Arthur-Demetrio/garra/servo_imgs/servo1_0.jpeg

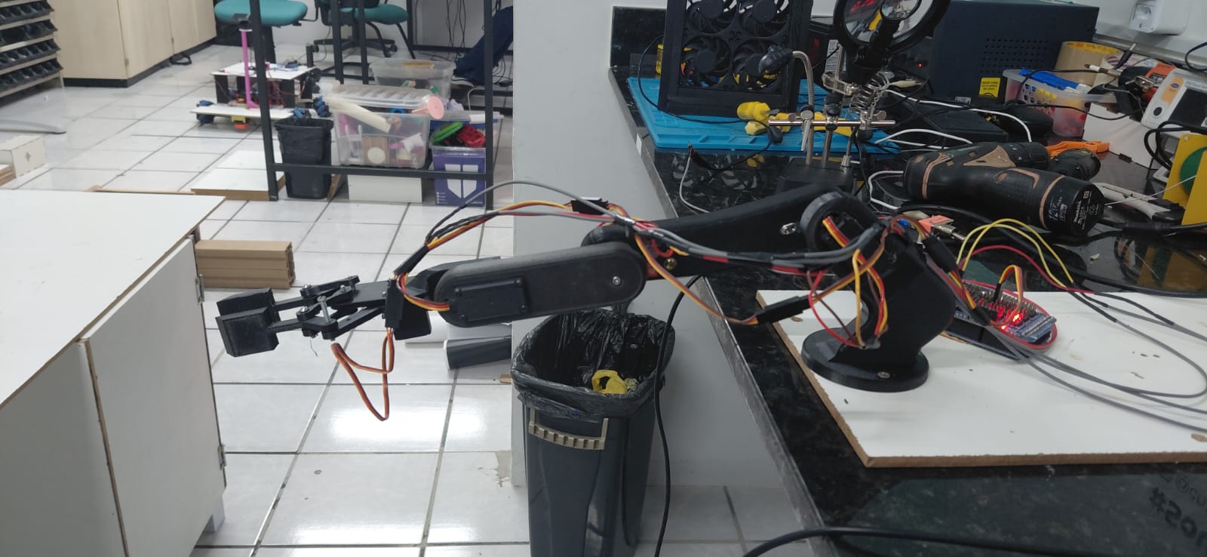
servo_imgs/servo1_0.jpeg
