Arthur-Demetrio/garra/servo_imgs/servo1_0_novo.jpeg

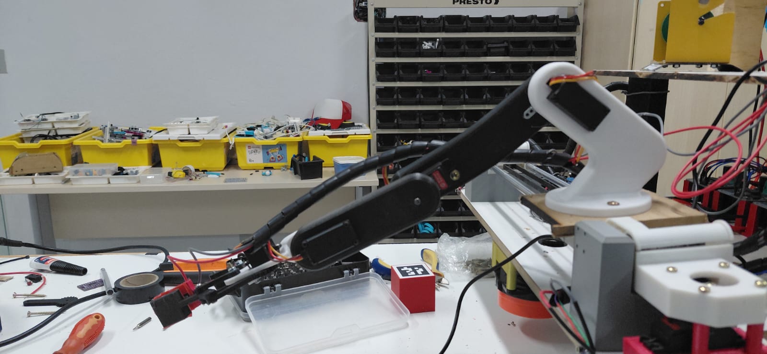
servo_imgs/servo1_0_novo.jpeg
