Arthur-Demetrio/garra/servo_imgs/servo1_180.jpeg

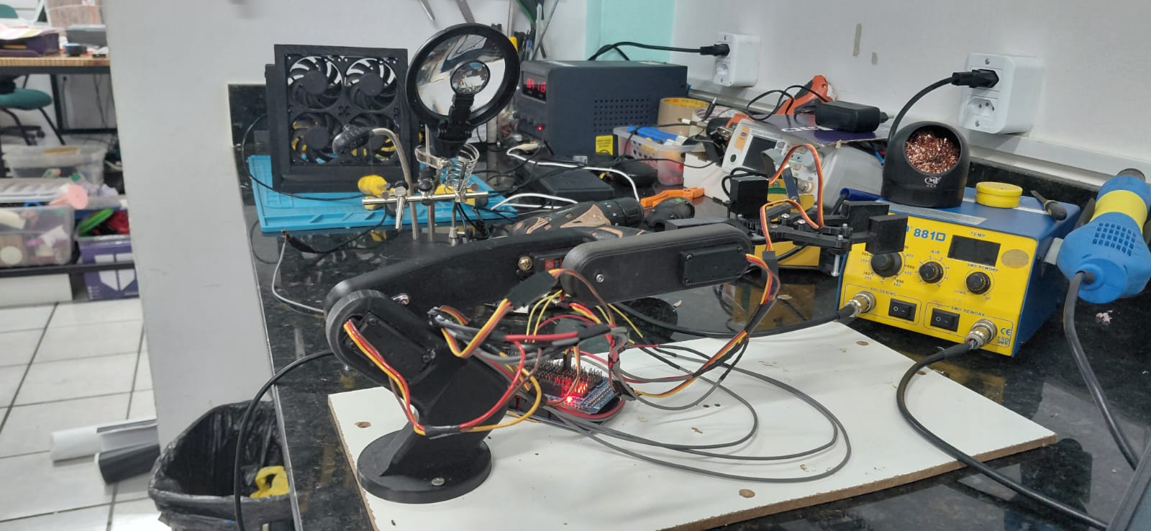
servo_imgs/servo1_180.jpeg
