Arthur-Demetrio/garra/servo_imgs/servo2_0.jpeg

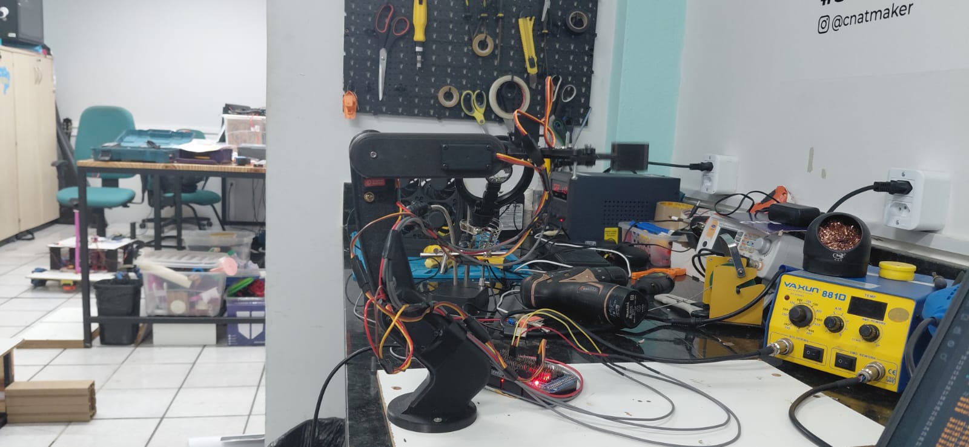
servo_imgs/servo2_0.jpeg
