Arthur-Demetrio/garra/servo_imgs/servo2_180.jpeg

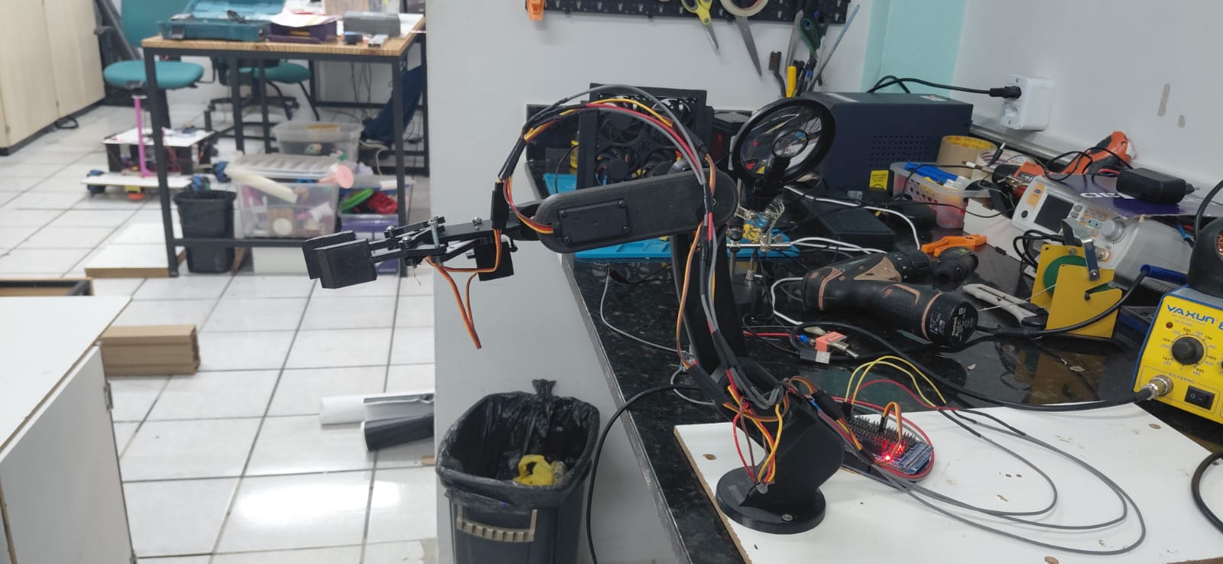
servo_imgs/servo2_180.jpeg
