Arthur-Demetrio/garra/servo_imgs/servo3_0.jpeg

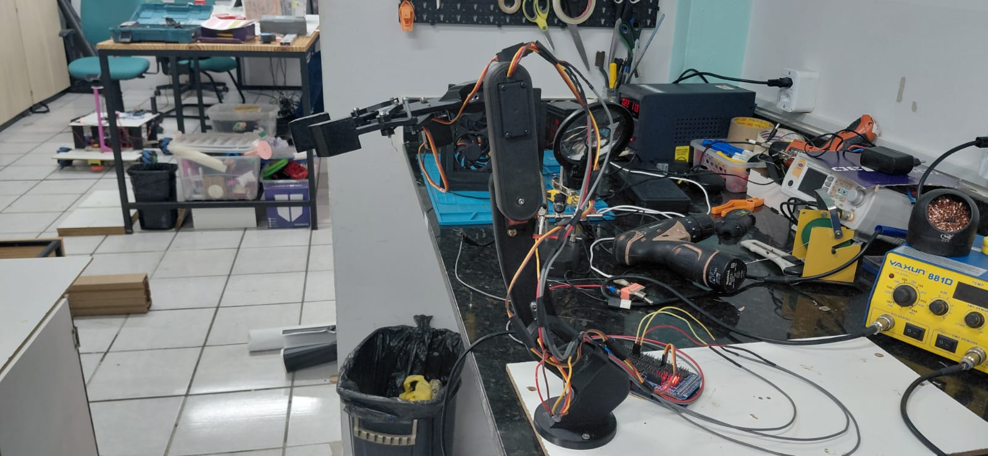
servo_imgs/servo3_0.jpeg
