Arthur-Demetrio/garra/servo_imgs/servo3_180.jpeg

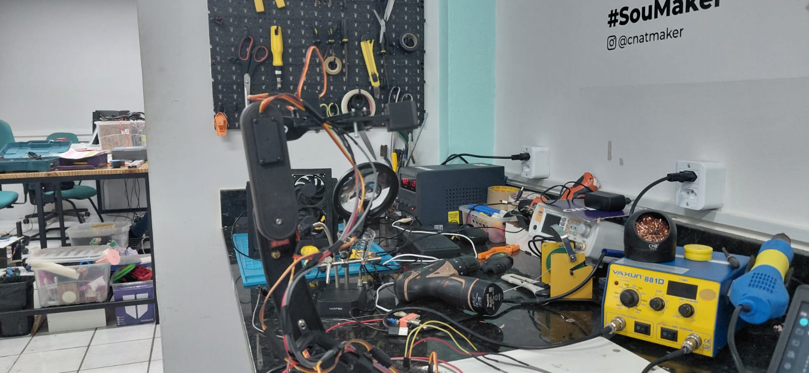
servo_imgs/servo3_180.jpeg
