Arthur-Demetrio/garra/garra_final_description/config/frame_overrides.csv

link | parent_joint | joint_type | rule | original_roll_deg | original_pitch_deg | original_yaw_deg | post_roll_deg | post_pitch_deg | post_yaw_deg | role
Base | R_gido_73 | fixed | keep | -92.083819 | 0.000000 | 90.000000 | -92.083819 | 0.000000 | 90.000000 | unchanged
Engr_1 | Revolucionar_91 | continuous | auto | -92.940419 | 44.859715 | 87.924992 | 0.000000 | 87.916181 | 0.000000 | revolute_axis_z
Engr_2 | Revolucionar_85 | continuous | auto | -92.096137 | 6.213100 | 89.773042 | 0.000000 | 87.916181 | 0.000000 | revolute_axis_z
Junta | Revolucionar_95 | continuous | auto | 87.695417 | -25.277392 | 90.984493 | 0.000000 | 87.916181 | 0.000000 | revolute_axis_z
Junta_1 | Revolucionar_87 | continuous | auto | -85.468634 | 62.597157 | -85.975312 | 0.000000 | 87.916181 | 0.000000 | revolute_axis_z
Junta_1_1 | Revolucionar_89 | continuous | auto | -87.888272 | -9.323392 | -90.342265 | 0.000000 | 87.916181 | 0.000000 | revolute_axis_z
Junta_2 | Revolucionar_93 | continuous | auto | 87.695417 | -25.277392 | 90.984493 | 0.000000 | 87.916181 | 0.000000 | revolute_axis_z
MOTOR_1 | R_gido_48 | fixed | keep | 0.000000 | -39.520181 | 0.000000 | 0.000000 | -39.520181 | 0.000000 | unchanged
MOTOR_1_1 | R_gido_65 | fixed | keep | -180.000000 | -88.536240 | 180.000000 | -180.000000 | -88.536240 | 180.000000 | unchanged
M_dulo_1 | R_gido_47 | fixed | keep | 0.000000 | -39.520181 | 0.000000 | 0.000000 | -39.520181 | 0.000000 | unchanged
M_dulo_2 | R_gido_50 | fixed | keep | -180.000000 | -88.536240 | 180.000000 | -180.000000 | -88.536240 | 180.000000 | unchanged
Motor | R_gido_77 | fixed | keep | -92.083819 | 0.000000 | 90.000000 | -92.083819 | 0.000000 | 90.000000 | unchanged
P_1 | Revolucionar_86 | continuous | auto | -92.085430 | 2.251740 | 89.918027 | 0.000000 | 87.916181 | 0.000000 | revolute_axis_z
P_1_1 | Revolucionar_92 | continuous | auto | -92.223140 | -20.387173 | 90.774800 | 0.000000 | 87.916181 | 0.000000 | revolute_axis_z
base_link |  | root | auto | 0.000000 | 0.000000 | 0.000000 | 0.000000 | 0.000000 | 0.000000 | root_x_forward_z_up
garra_final_showder_servo_horn | Revolucionar_46 | continuous | keep | 90.000000 | 65.479819 | 0.000000 | 90.000000 | 65.479819 | 0.000000 | revolute_axis_z
garra_final_showder_servo_horn_2 | Revolucionar_49 | continuous | keep | 90.000000 | 48.536240 | 0.000000 | 90.000000 | 48.536240 | 0.000000 | revolute_axis_z
garra_final_showder_servo_horn_3 | Revolucionar_72 | continuous | auto | 90.000000 | 50.416181 | 0.000000 | -90.000000 | 0.000000 | 0.000000 | revolute_axis_z
shoulder_motor | R_gido | fixed | keep | 0.000000 | 0.663392 | 0.000000 | 0.000000 | 0.663392 | 0.000000 | unchanged
