Arthur-Demetrio/garra/garra_final_description/meshes/Configura_o_1/Engr_1_collision.stl

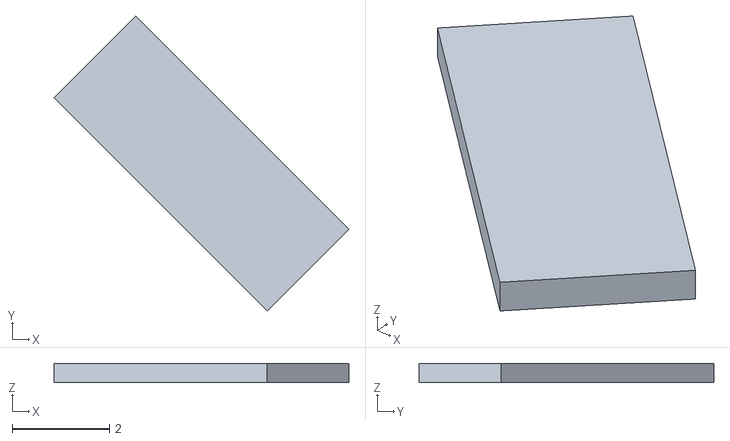
[picture p9: CAD file, 2026-11-09]
garra_final_description/meshes/Configura_o_1/Engr_1_collision.stl
6.06 x 6.06 x 0.4
