Arthur-Demetrio/garra/garra_final_description/meshes/garra_final/M_dulo_2_collision.stl

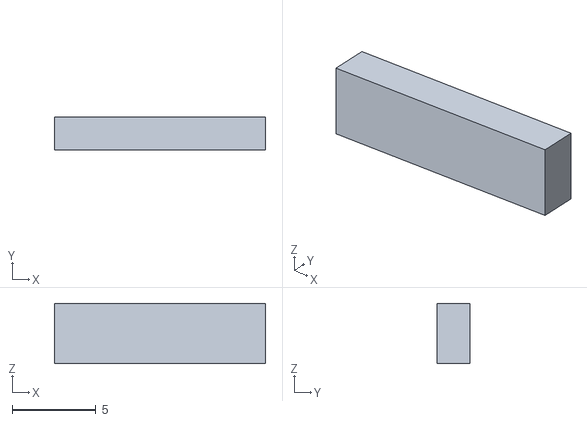
[picture p10: CAD file, 2026-11-09]
garra_final_description/meshes/garra_final/M_dulo_2_collision.stl
12.6 x 2.00 x 3.60
