Arthur-Demetrio/garra/garra_final_description/meshes/Nova_Pin_a/Componente5_collision.stl

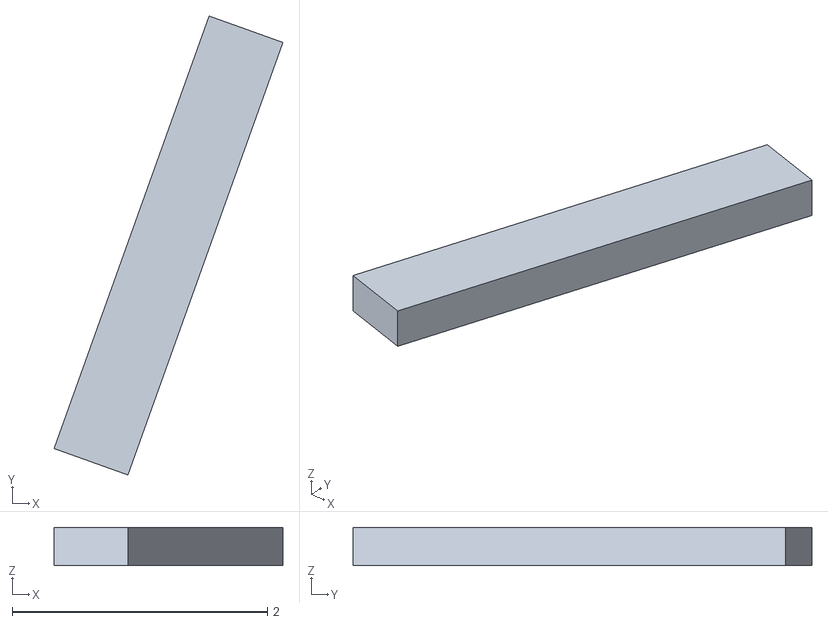
[picture p11: CAD file, 2026-10-30]
garra_final_description/meshes/Nova_Pin_a/Componente5_collision.stl
1.79 x 3.60 x 0.3
