Arthur-Demetrio/garra/garra_final_description/meshes/Configura_o_1/Junta_1_1_collision.stl

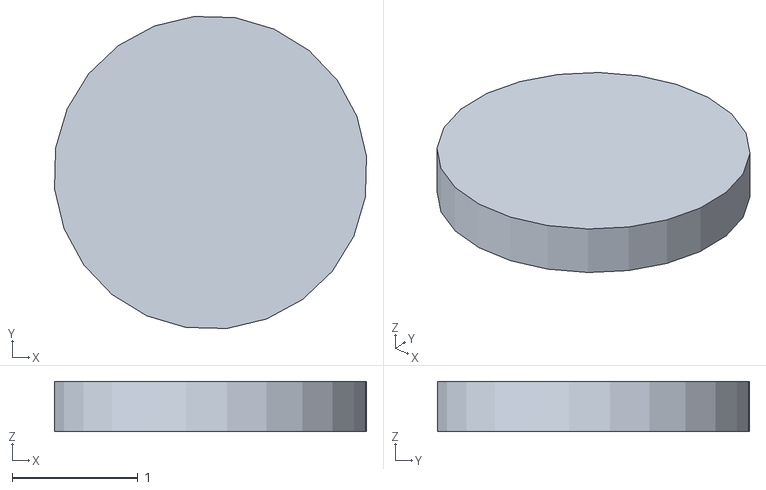
[picture p12: CAD file, 2026-11-09]
garra_final_description/meshes/Configura_o_1/Junta_1_1_collision.stl
2.48 x 2.48 x 0.4
