Arthur-Demetrio/garra/garra_final_description/meshes/garra_final/MOTOR_1_1_collision.stl

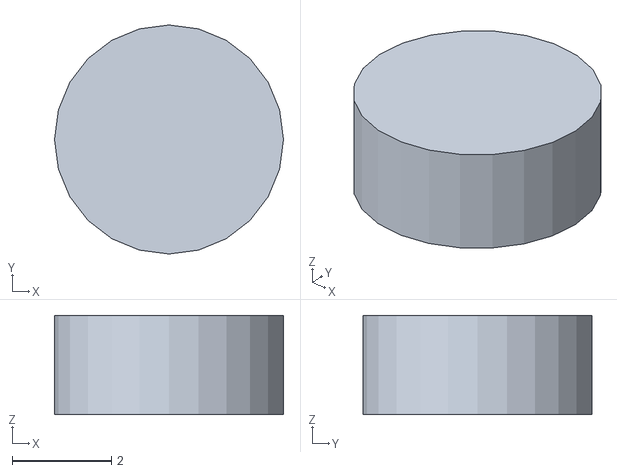
[picture p13: CAD file, 2026-11-09]
garra_final_description/meshes/garra_final/MOTOR_1_1_collision.stl
4.61 x 4.61 x 2.00
