Arthur-Demetrio/garra/garra_final_description/meshes/Nova_Pin_a/Componente6_Espelhar_collision.stl

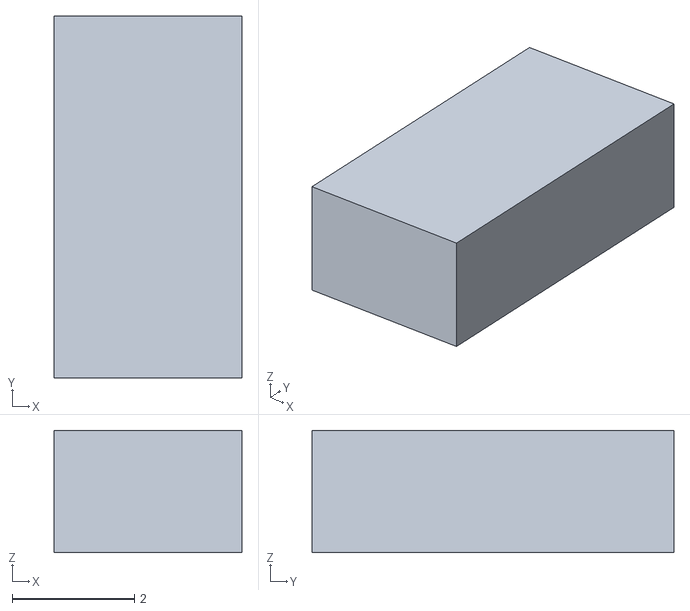
[picture p14: CAD file, 2026-10-30]
garra_final_description/meshes/Nova_Pin_a/Componente6_Espelhar_collision.stl
3.07 x 5.92 x 2.00
