Arthur-Demetrio/garra/garra_final_description/meshes/Configura_o_1/Engr_2_collision.stl

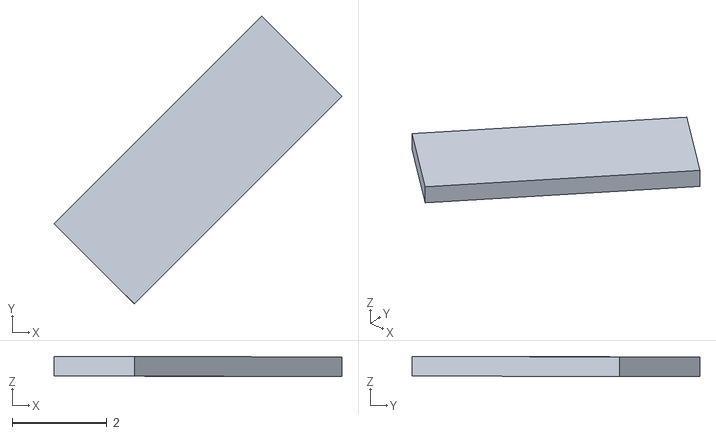
[picture p15: CAD file, 2026-11-09]
garra_final_description/meshes/Configura_o_1/Engr_2_collision.stl
6.08 x 6.08 x 0.428
