Arthur-Demetrio/garra/garra_final_description/meshes/garra_final/Caixa_motor_pequeno_collision.stl

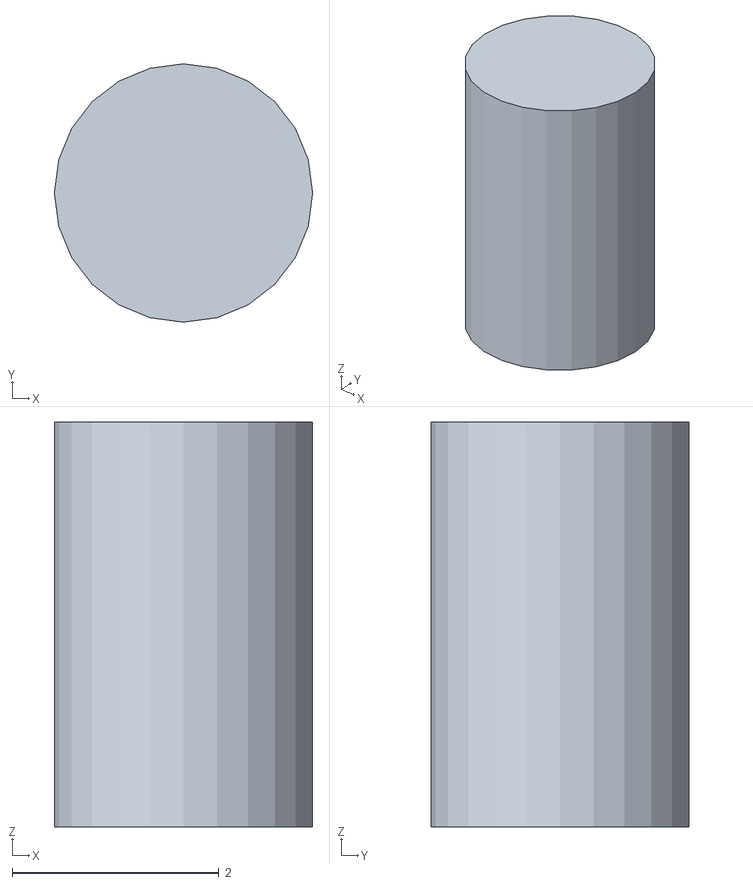
[picture p16: CAD file, 2026-10-30]
garra_final_description/meshes/garra_final/Caixa_motor_pequeno_collision.stl
2.50 x 2.50 x 3.92
