Arthur-Demetrio/garra/garra_final_description/meshes/Nova_Pin_a/Componente4_collision.stl

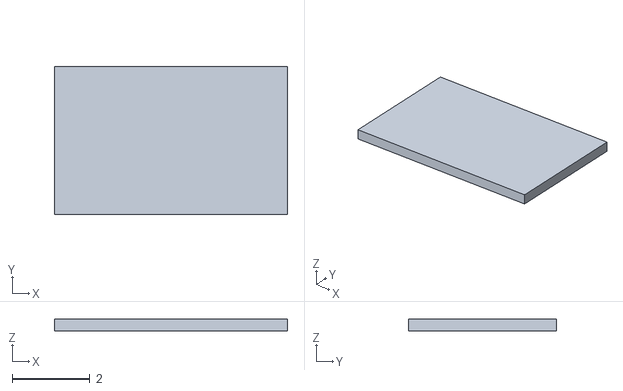
[picture p17: CAD file, 2026-10-30]
garra_final_description/meshes/Nova_Pin_a/Componente4_collision.stl
6.00 x 3.80 x 0.3
