Arthur-Demetrio/garra/garra_final_description/meshes/garra_final/base_link_collision.stl

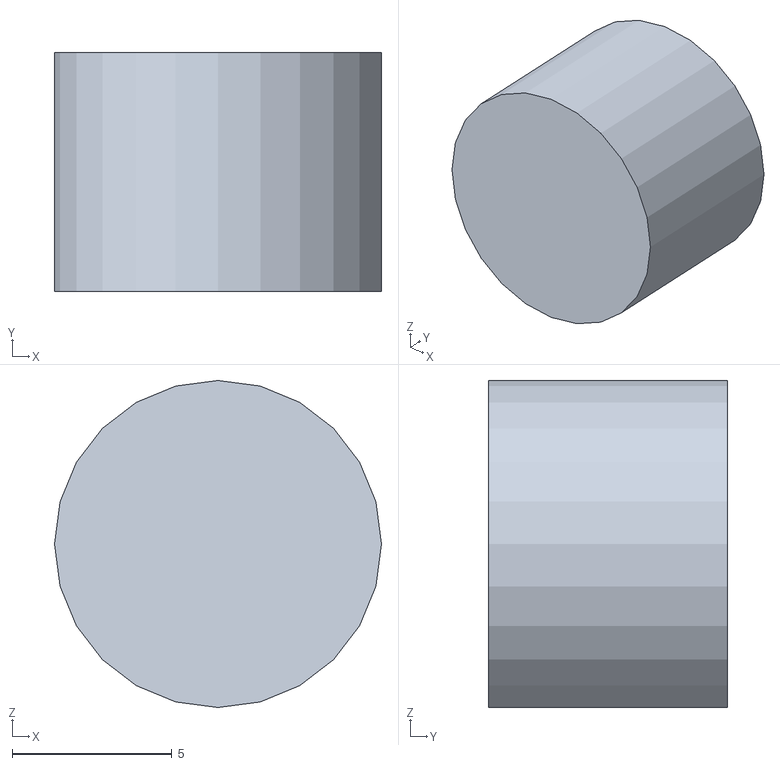
[picture p18: CAD file, 2026-10-30]
garra_final_description/meshes/garra_final/base_link_collision.stl
10.2 x 7.50 x 10.2
