Arthur-Demetrio/garra/garra_final_description/meshes/garra_final/shoulder_motor_collision.stl

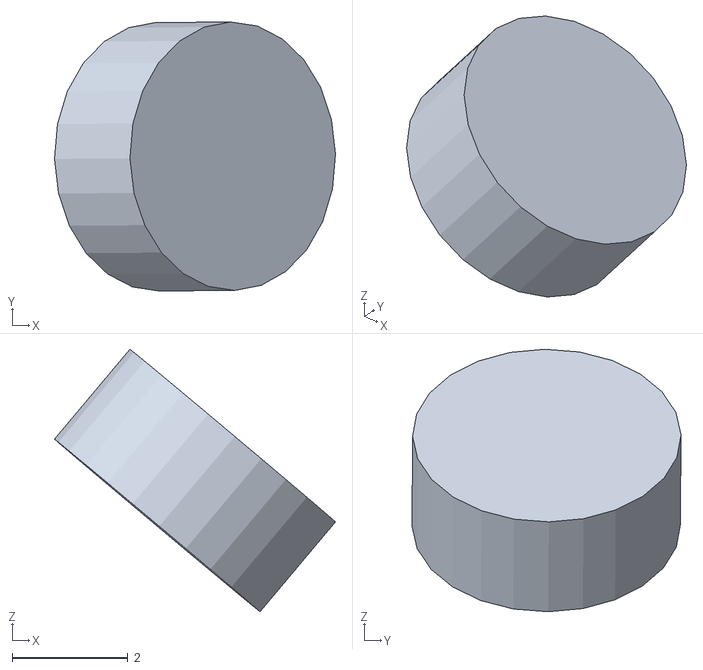
[picture p19: CAD file, 2026-10-30]
garra_final_description/meshes/garra_final/shoulder_motor_collision.stl
4.85 x 4.64 x 4.53
