Arthur-Demetrio/garra/garra_final_description/meshes/garra_final/M_dulo_1_collision.stl

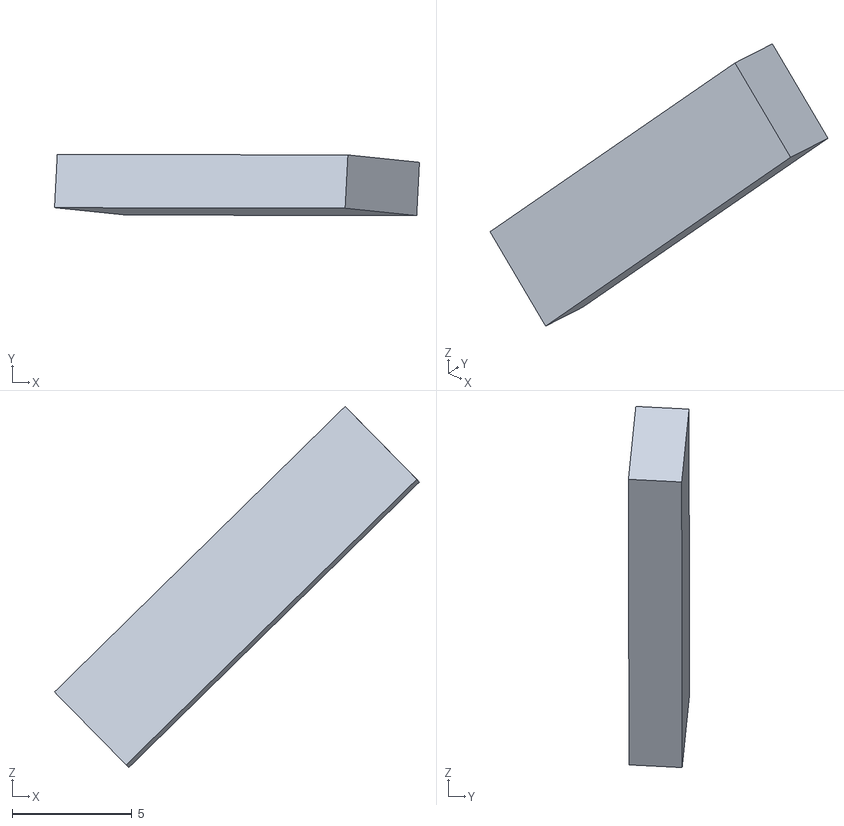
[picture p20: CAD file, 2026-10-30]
garra_final_description/meshes/garra_final/M_dulo_1_collision.stl
15.2 x 2.55 x 15.1
