Arthur-Demetrio/garra/garra_final_description/meshes/Nova_Pin_a/Healical_Gear_8R_0_00_m_1_0_collision.stl

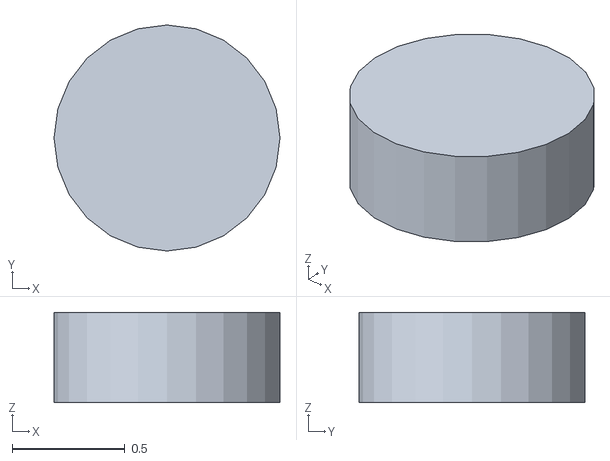
[picture p21: CAD file, 2026-10-30]
garra_final_description/meshes/Nova_Pin_a/Healical_Gear_8R_0_00_m_1_0_collision.stl
1.00 x 1.00 x 0.4
