Arthur-Demetrio/garra/garra_final_description/meshes/Configura_o_1/Base_collision.stl

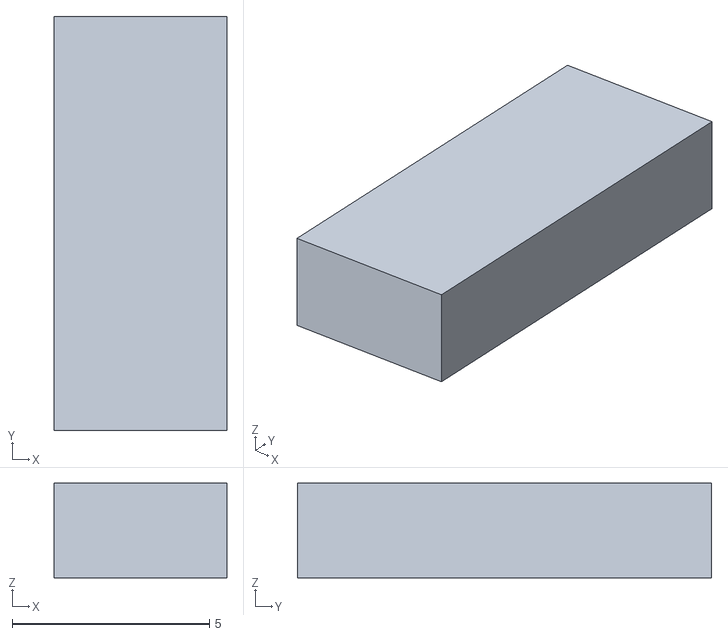
[picture p22: CAD file, 2026-11-09]
garra_final_description/meshes/Configura_o_1/Base_collision.stl
4.38 x 10.5 x 2.40
