Arthur-Demetrio/garra/garra_final_description/meshes/garra_final/garra_final_showder_servo_horn_3_collision.stl

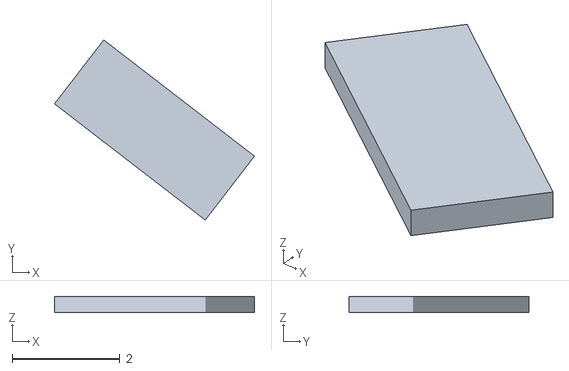
[picture p23: CAD file, 2026-10-30]
garra_final_description/meshes/garra_final/garra_final_showder_servo_horn_3_collision.stl
3.72 x 3.35 x 0.3
