Arthur-Demetrio/garra/garra_final_description/meshes/Nova_Pin_a/Componente4_Espelhar_collision.stl

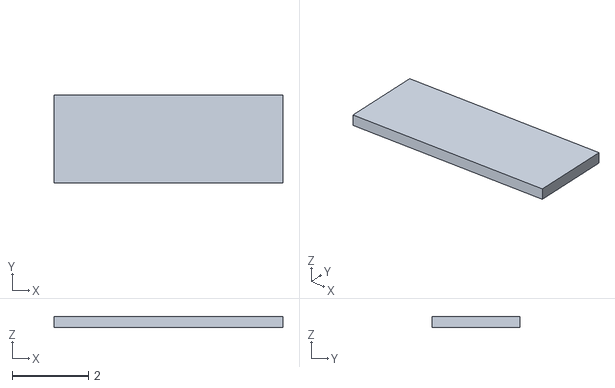
[picture p24: CAD file, 2026-10-30]
garra_final_description/meshes/Nova_Pin_a/Componente4_Espelhar_collision.stl
6.00 x 2.30 x 0.3
