Arthur-Demetrio/garra/garra_final_description/meshes/Configura_o_1/P_1_collision.stl

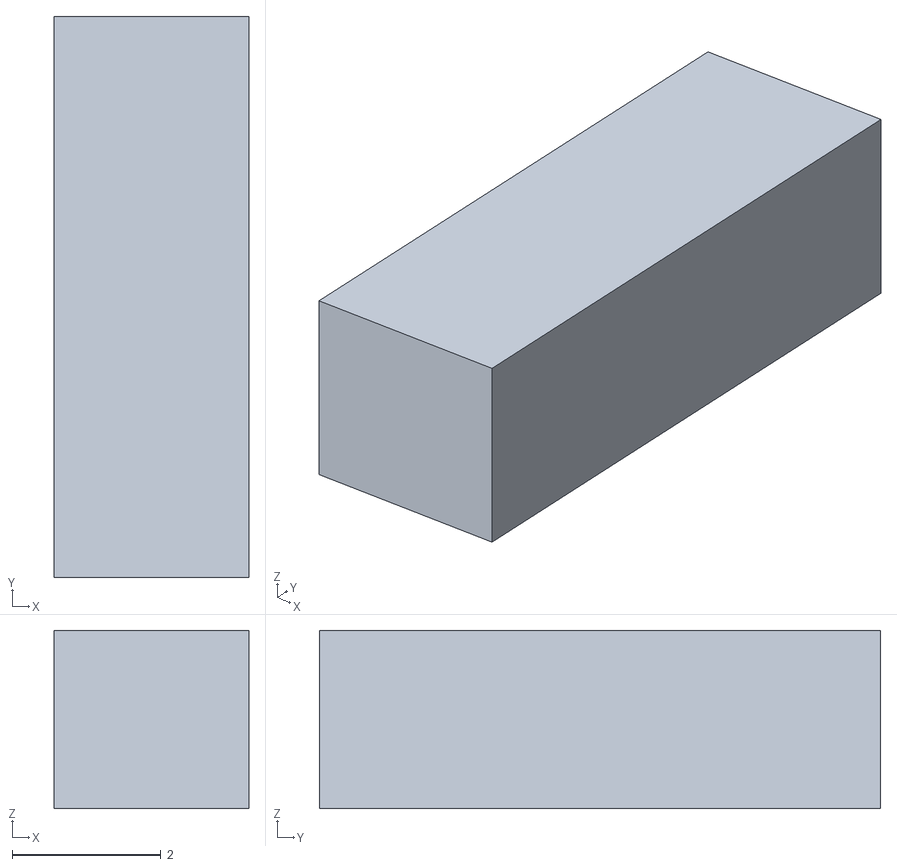
[picture p25: CAD file, 2026-11-09]
garra_final_description/meshes/Configura_o_1/P_1_collision.stl
2.63 x 7.56 x 2.40
