Arthur-Demetrio/garra/garra_final_description/meshes/Nova_Pin_a/Healical_Gear_20R_0_00_m_1_0_1_collision.stl

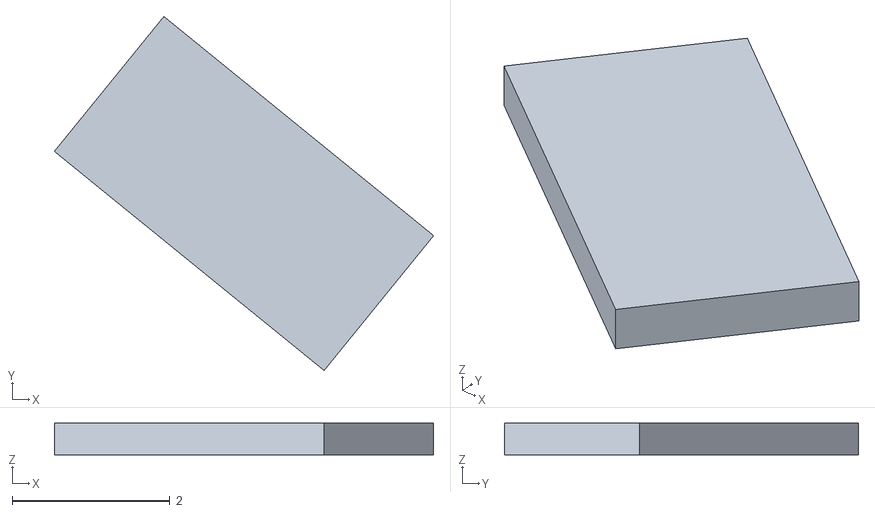
[picture p26: CAD file, 2026-10-30]
garra_final_description/meshes/Nova_Pin_a/Healical_Gear_20R_0_00_m_1_0_1_collision.stl
4.80 x 4.48 x 0.4
