Arthur-Demetrio/garra/garra_final_description/meshes/Configura_o_1/Motor_collision.stl

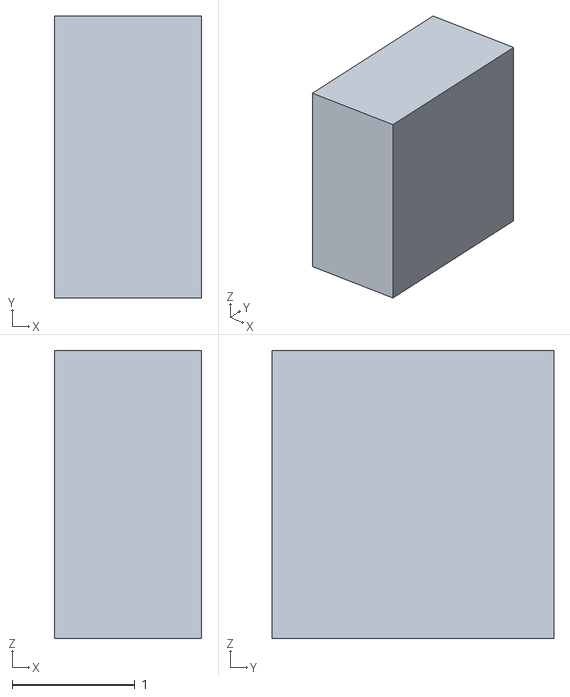
[picture p27: CAD file, 2026-11-09]
garra_final_description/meshes/Configura_o_1/Motor_collision.stl
1.20 x 2.30 x 2.35
