Arthur-Demetrio/garra/garra_final_description/meshes/garra_final/motor_pequeno_collision.stl

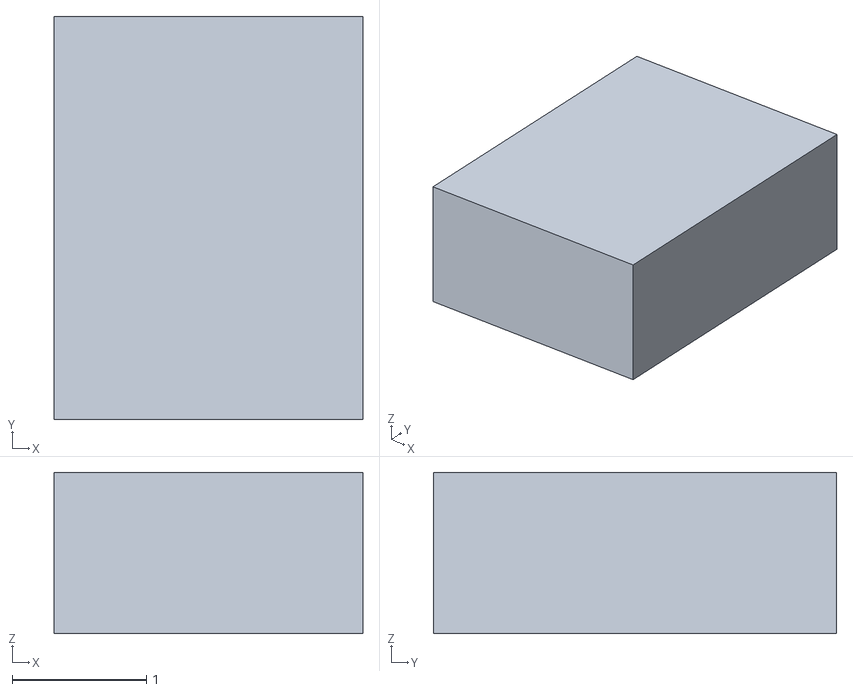
[picture p28: CAD file, 2026-10-30]
garra_final_description/meshes/garra_final/motor_pequeno_collision.stl
2.30 x 3.00 x 1.20
