Arthur-Demetrio/garra/(list of files, cad)

Other CAD files:
garra_final_description/meshes/Configura_o_1/Junta_collision.stl
garra_final_description/meshes/Nova_Pin_a/Componente6_collision.stl
garra_final_description/meshes/Configura_o_1/Junta_2_collision.stl
garra_final_description/meshes/Nova_Pin_a/Componente5_Espelhar_1_collision.stl
garra_final_description/meshes/Configura_o_1/Junta_1_collision.stl
garra_final_description/meshes/garra_final/MOTOR_1_collision.stl
garra_final_description/meshes/Nova_Pin_a/Healical_Gear_20R_0_00_m_1_0_collision.stl
garra_final_description/meshes/Configura_o_1/P_1_1_collision.stl
garra_final_description/meshes/Nova_Pin_a/Componente5_Espelhar_collision.stl
