Arthur-Demetrio/garra/garra_final_description/urdf/garra_final.urdf

<?xml version='1.0' encoding='utf-8'?>
<robot name="garra_final">
  <!-- Materials -->
  <material name="Laminado_vermelho_fosco">
    <color rgba="0.769 0.208 0.153 1.0" />
  </material>
  <material name="Alum_nio_prata_anodizada">
    <color rgba="0.537 0.537 0.537 1.0" />
  </material>
  <material name="A_o">
    <color rgba="0.627 0.627 0.627 1.0" />
  </material>
  <link name="base_link">
    <inertial>
      <origin xyz="0.000333 0.000000 0.041536" rpy="0 0 0" />
      <mass value="0.122493" />
      <inertia ixx="1.488707e-04" ixy="0.000000e+00" ixz="3.196556e-05" iyy="1.961067e-04" iyz="0.000000e+00" izz="8.370648e-05" />
    </inertial>
    <visual>
      <origin xyz="0.000000 0.000000 0.000000" rpy="0.000000 0.000000 0.000000" />
      <geometry>
        <mesh filename="package://garra_final_description/meshes/garra_final/base_link.dae" scale="1 1 1" />
      </geometry>
      <material name="Laminado_vermelho_fosco" />
    </visual>
    <collision>
      <origin xyz="0.000000 0.000000 0.000000" rpy="0.000000 0.000000 0.000000" />
      <geometry>
        <mesh filename="package://garra_final_description/meshes/garra_final/base_link.dae" scale="1 1 1" />
      </geometry>
    </collision>
  </link>
  <link name="shoulder_motor">
    <inertial>
      <origin xyz="-0.016764 -0.000763 0.079997" rpy="0 0 0" />
      <mass value="0.089211" />
      <inertia ixx="1.929411e-05" ixy="-4.785893e-08" ixz="4.449074e-06" iyy="1.495797e-05" iyz="4.048953e-08" izz="2.086252e-05" />
    </inertial>
    <visual>
      <origin xyz="0.000000 0.000000 0.000000" rpy="0.000000 0.000000 0.000000" />
      <geometry>
        <mesh filename="package://garra_final_description/meshes/garra_final/shoulder_motor.dae" scale="1 1 1" />
      </geometry>
      <material name="Alum_nio_prata_anodizada" />
    </visual>
    <collision>
      <origin xyz="0.000000 0.000000 0.000000" rpy="0.000000 0.000000 0.000000" />
      <geometry>
        <mesh filename="package://garra_final_description/meshes/garra_final/shoulder_motor.dae" scale="1 1 1" />
      </geometry>
    </collision>
  </link>
  <link name="garra_final_showder_servo_horn">
    <inertial>
      <origin xyz="-0.006829 0.005264 -0.001500" rpy="0 0 0" />
      <mass value="0.007175" />
      <inertia ixx="1.000000e-06" ixy="2.998637e-07" ixz="0.000000e+00" iyy="1.000000e-06" iyz="0.000000e+00" izz="1.000000e-06" />
    </inertial>
    <visual>
      <origin xyz="0.015787 -0.085385 -0.003000" rpy="0.000000 0.000000 0.000000" />
      <geometry>
        <mesh filename="package://garra_final_description/meshes/garra_final/garra_final_showder_servo_horn.dae" scale="1 1 1" />
      </geometry>
      <material name="A_o" />
    </visual>
    <collision>
      <origin xyz="0.015787 -0.085385 -0.003000" rpy="0.000000 0.000000 0.000000" />
      <geometry>
        <mesh filename="package://garra_final_description/meshes/garra_final/garra_final_showder_servo_horn.dae" scale="1 1 1" />
      </geometry>
    </collision>
  </link>
  <link name="M_dulo_1">
    <inertial>
      <origin xyz="0.018424 -0.033973 0.129529" rpy="0 0 0" />
      <mass value="0.096143" />
      <inertia ixx="1.195199e-04" ixy="-1.450615e-07" ixz="-1.036412e-04" iyy="2.332425e-04" iyz="-1.168777e-07" izz="1.209736e-04" />
    </inertial>
    <visual>
      <origin xyz="0.000000 0.000000 0.000000" rpy="0.000000 0.000000 0.000000" />
      <geometry>
        <mesh filename="package://garra_final_description/meshes/garra_final/M_dulo_1.dae" scale="1 1 1" />
      </geometry>
      <material name="Laminado_vermelho_fosco" />
    </visual>
    <collision>
      <origin xyz="0.000000 0.000000 0.000000" rpy="0.000000 0.000000 0.000000" />
      <geometry>
        <mesh filename="package://garra_final_description/meshes/garra_final/M_dulo_1.dae" scale="1 1 1" />
      </geometry>
    </collision>
  </link>
  <link name="MOTOR_1">
    <inertial>
      <origin xyz="0.053925 -0.033237 0.166019" rpy="0 0 0" />
      <mass value="0.089211" />
      <inertia ixx="2.086308e-05" ixy="-4.010090e-08" ixz="-4.448976e-06" iyy="1.495797e-05" iyz="-4.818499e-08" izz="1.929356e-05" />
    </inertial>
    <visual>
      <origin xyz="0.000000 0.000000 0.000000" rpy="0.000000 0.000000 0.000000" />
      <geometry>
        <mesh filename="package://garra_final_description/meshes/garra_final/MOTOR_1.dae" scale="1 1 1" />
      </geometry>
      <material name="Alum_nio_prata_anodizada" />
    </visual>
    <collision>
      <origin xyz="0.000000 0.000000 0.000000" rpy="0.000000 0.000000 0.000000" />
      <geometry>
        <mesh filename="package://garra_final_description/meshes/garra_final/MOTOR_1.dae" scale="1 1 1" />
      </geometry>
    </collision>
  </link>
  <link name="garra_final_showder_servo_horn_2">
    <inertial>
      <origin xyz="-0.006829 0.005264 0.001500" rpy="0 0 0" />
      <mass value="0.007175" />
      <inertia ixx="1.000000e-06" ixy="2.998637e-07" ixz="0.000000e+00" iyy="1.000000e-06" iyz="0.000000e+00" izz="1.000000e-06" />
    </inertial>
    <visual>
      <origin xyz="0.015787 -0.085385 0.000000" rpy="0.000000 0.000000 0.000000" />
      <geometry>
        <mesh filename="package://garra_final_description/meshes/garra_final/garra_final_showder_servo_horn_2.dae" scale="1 1 1" />
      </geometry>
      <material name="A_o" />
    </visual>
    <collision>
      <origin xyz="0.015787 -0.085385 0.000000" rpy="0.000000 0.000000 0.000000" />
      <geometry>
        <mesh filename="package://garra_final_description/meshes/garra_final/garra_final_showder_servo_horn_2.dae" scale="1 1 1" />
      </geometry>
    </collision>
  </link>
  <link name="M_dulo_2">
    <inertial>
      <origin xyz="0.104698 0.000412 0.173614" rpy="0 0 0" />
      <mass value="0.070749" />
      <inertia ixx="1.156834e-05" ixy="1.910002e-07" ixz="-1.551575e-08" iyy="9.825746e-05" iyz="7.836475e-10" izz="9.164356e-05" />
    </inertial>
    <visual>
      <origin xyz="0.000000 0.000000 0.000000" rpy="0.000000 0.000000 0.000000" />
      <geometry>
        <mesh filename="package://garra_final_description/meshes/garra_final/M_dulo_2.dae" scale="1 1 1" />
      </geometry>
      <material name="Laminado_vermelho_fosco" />
    </visual>
    <collision>
      <origin xyz="0.000000 0.000000 0.000000" rpy="0.000000 0.000000 0.000000" />
      <geometry>
        <mesh filename="package://garra_final_description/meshes/garra_final/M_dulo_2.dae" scale="1 1 1" />
      </geometry>
    </collision>
  </link>
  <link name="MOTOR_1_1">
    <inertial>
      <origin xyz="0.137478 0.000880 0.173458" rpy="0 0 0" />
      <mass value="0.089211" />
      <inertia ixx="1.556066e-05" ixy="-6.268823e-08" ixz="-2.821390e-10" iyy="1.495797e-05" iyz="-2.536528e-10" izz="2.459598e-05" />
    </inertial>
    <visual>
      <origin xyz="0.000000 0.000000 0.000000" rpy="0.000000 0.000000 0.000000" />
      <geometry>
        <mesh filename="package://garra_final_description/meshes/garra_final/MOTOR_1_1.dae" scale="1 1 1" />
      </geometry>
      <material name="Alum_nio_prata_anodizada" />
    </visual>
    <collision>
      <origin xyz="0.000000 0.000000 0.000000" rpy="0.000000 0.000000 0.000000" />
      <geometry>
        <mesh filename="package://garra_final_description/meshes/garra_final/MOTOR_1_1.dae" scale="1 1 1" />
      </geometry>
    </collision>
  </link>
  <link name="garra_final_showder_servo_horn_3">
    <inertial>
      <origin xyz="-0.000294 -0.008617 0.001500" rpy="0 0 0" />
      <mass value="0.007175" />
      <inertia ixx="1.000000e-06" ixy="-2.116718e-08" ixz="0.000000e+00" iyy="1.000000e-06" iyz="0.000000e+00" izz="1.000000e-06" />
    </inertial>
    <visual>
      <origin xyz="-0.055746 0.066574 0.003000" rpy="-3.141593 0.000000 0.879928" />
      <geometry>
        <mesh filename="package://garra_final_description/meshes/garra_final/garra_final_showder_servo_horn_3.dae" scale="1 1 1" />
      </geometry>
      <material name="A_o" />
    </visual>
    <collision>
      <origin xyz="-0.055746 0.066574 0.003000" rpy="-3.141593 0.000000 0.879928" />
      <geometry>
        <mesh filename="package://garra_final_description/meshes/garra_final/garra_final_showder_servo_horn_3.dae" scale="1 1 1" />
      </geometry>
    </collision>
  </link>
  <link name="Base">
    <inertial>
      <origin xyz="-0.057386 -0.026808 0.002045" rpy="0 0 0" />
      <mass value="0.191532" />
      <inertia ixx="1.578035e-04" ixy="-3.919167e-07" ixz="4.397693e-08" iyy="1.697283e-05" iyz="-2.047143e-07" izz="1.622377e-04" />
    </inertial>
    <visual>
      <origin xyz="0.000000 0.000000 0.000000" rpy="0.000000 0.000000 0.000000" />
      <geometry>
        <mesh filename="package://garra_final_description/meshes/Configura_o_1/Base.dae" scale="1 1 1" />
      </geometry>
      <material name="A_o" />
    </visual>
    <collision>
      <origin xyz="0.000000 0.000000 0.000000" rpy="0.000000 0.000000 0.000000" />
      <geometry>
        <mesh filename="package://garra_final_description/meshes/Configura_o_1/Base.dae" scale="1 1 1" />
      </geometry>
    </collision>
  </link>
  <link name="Motor">
    <inertial>
      <origin xyz="0.044221 0.026721 0.011750" rpy="0 0 0" />
      <mass value="0.050915" />
      <inertia ixx="4.587663e-06" ixy="0.000000e+00" ixz="0.000000e+00" iyy="2.954137e-06" iyz="0.000000e+00" izz="2.855489e-06" />
    </inertial>
    <visual>
      <origin xyz="0.000000 0.000000 0.000000" rpy="0.000000 0.000000 0.000000" />
      <geometry>
        <mesh filename="package://garra_final_description/meshes/Configura_o_1/Motor.dae" scale="1 1 1" />
      </geometry>
      <material name="A_o" />
    </visual>
    <collision>
      <origin xyz="0.000000 0.000000 0.000000" rpy="0.000000 0.000000 0.000000" />
      <geometry>
        <mesh filename="package://garra_final_description/meshes/Configura_o_1/Motor.dae" scale="1 1 1" />
      </geometry>
    </collision>
  </link>
  <link name="Engr_2">
    <inertial>
      <origin xyz="-0.012589 -0.010130 -0.001895" rpy="0 0 0" />
      <mass value="0.020209" />
      <inertia ixx="2.815627e-06" ixy="-2.942728e-06" ixz="-1.341961e-08" iyy="4.114715e-06" iyz="-1.102947e-08" izz="6.875480e-06" />
    </inertial>
    <visual>
      <origin xyz="0.062176 0.062886 0.004000" rpy="3.141593 0.000000 1.462285" />
      <geometry>
        <mesh filename="package://garra_final_description/meshes/Configura_o_1/Engr_2.dae" scale="1 1 1" />
      </geometry>
      <material name="A_o" />
    </visual>
    <collision>
      <origin xyz="0.062176 0.062886 0.004000" rpy="3.141593 0.000000 1.462285" />
      <geometry>
        <mesh filename="package://garra_final_description/meshes/Configura_o_1/Engr_2.dae" scale="1 1 1" />
      </geometry>
    </collision>
  </link>
  <link name="Junta_1">
    <inertial>
      <origin xyz="-0.013345 -0.006703 -0.002000" rpy="0 0 0" />
      <mass value="0.006788" />
      <inertia ixx="1.000000e-06" ixy="-4.401022e-07" ixz="0.000000e+00" iyy="1.000000e-06" iyz="0.000000e+00" izz="1.165360e-06" />
    </inertial>
    <visual>
      <origin xyz="0.096130 0.039228 -0.008000" rpy="0.000000 0.000000 -0.476992" />
      <geometry>
        <mesh filename="package://garra_final_description/meshes/Configura_o_1/Junta_1.dae" scale="1 1 1" />
      </geometry>
      <material name="A_o" />
    </visual>
    <collision>
      <origin xyz="0.096130 0.039228 -0.008000" rpy="0.000000 0.000000 -0.476992" />
      <geometry>
        <mesh filename="package://garra_final_description/meshes/Configura_o_1/Junta_1.dae" scale="1 1 1" />
      </geometry>
    </collision>
  </link>
  <link name="Junta_1_1">
    <inertial>
      <origin xyz="-0.013345 -0.006703 0.002000" rpy="0 0 0" />
      <mass value="0.006788" />
      <inertia ixx="1.000000e-06" ixy="-4.401022e-07" ixz="0.000000e+00" iyy="1.000000e-06" iyz="0.000000e+00" izz="1.165360e-06" />
    </inertial>
    <visual>
      <origin xyz="0.041768 0.030664 -0.004000" rpy="0.000000 0.000000 -1.733629" />
      <geometry>
        <mesh filename="package://garra_final_description/meshes/Configura_o_1/Junta_1_1.dae" scale="1 1 1" />
      </geometry>
      <material name="A_o" />
    </visual>
    <collision>
      <origin xyz="0.041768 0.030664 -0.004000" rpy="0.000000 0.000000 -1.733629" />
      <geometry>
        <mesh filename="package://garra_final_description/meshes/Configura_o_1/Junta_1_1.dae" scale="1 1 1" />
      </geometry>
    </collision>
  </link>
  <link name="Engr_1">
    <inertial>
      <origin xyz="-0.000027 0.015123 -0.002000" rpy="0 0 0" />
      <mass value="0.023094" />
      <inertia ixx="6.798312e-06" ixy="1.133009e-08" ixz="0.000000e+00" iyy="1.000000e-06" iyz="0.000000e+00" izz="7.204434e-06" />
    </inertial>
    <visual>
      <origin xyz="0.071958 -0.005705 0.004000" rpy="3.141593 0.000000 0.787188" />
      <geometry>
        <mesh filename="package://garra_final_description/meshes/Configura_o_1/Engr_1.dae" scale="1 1 1" />
      </geometry>
      <material name="A_o" />
    </visual>
    <collision>
      <origin xyz="0.071958 -0.005705 0.004000" rpy="3.141593 0.000000 0.787188" />
      <geometry>
        <mesh filename="package://garra_final_description/meshes/Configura_o_1/Engr_1.dae" scale="1 1 1" />
      </geometry>
    </collision>
  </link>
  <link name="Junta_2">
    <inertial>
      <origin xyz="0.007173 0.013099 -0.002000" rpy="0 0 0" />
      <mass value="0.006788" />
      <inertia ixx="1.000000e-06" ixy="-4.622335e-07" ixz="0.000000e+00" iyy="1.000000e-06" iyz="0.000000e+00" izz="1.165360e-06" />
    </inertial>
    <visual>
      <origin xyz="-0.085134 -0.072371 -0.008000" rpy="0.000000 0.000000 2.012283" />
      <geometry>
        <mesh filename="package://garra_final_description/meshes/Configura_o_1/Junta_2.dae" scale="1 1 1" />
      </geometry>
      <material name="A_o" />
    </visual>
    <collision>
      <origin xyz="-0.085134 -0.072371 -0.008000" rpy="0.000000 0.000000 2.012283" />
      <geometry>
        <mesh filename="package://garra_final_description/meshes/Configura_o_1/Junta_2.dae" scale="1 1 1" />
      </geometry>
    </collision>
  </link>
  <link name="Junta">
    <inertial>
      <origin xyz="0.007173 0.013099 0.002000" rpy="0 0 0" />
      <mass value="0.006788" />
      <inertia ixx="1.000000e-06" ixy="-4.622335e-07" ixz="0.000000e+00" iyy="1.000000e-06" iyz="0.000000e+00" izz="1.165360e-06" />
    </inertial>
    <visual>
      <origin xyz="-0.092300 0.010454 -0.004000" rpy="0.000000 0.000000 2.012283" />
      <geometry>
        <mesh filename="package://garra_final_description/meshes/Configura_o_1/Junta.dae" scale="1 1 1" />
      </geometry>
      <material name="A_o" />
    </visual>
    <collision>
      <origin xyz="-0.092300 0.010454 -0.004000" rpy="0.000000 0.000000 2.012283" />
      <geometry>
        <mesh filename="package://garra_final_description/meshes/Configura_o_1/Junta.dae" scale="1 1 1" />
      </geometry>
    </collision>
  </link>
  <link name="P_1">
    <inertial>
      <origin xyz="-0.043864 0.017082 0.002000" rpy="0 0 0" />
      <mass value="0.067383" />
      <inertia ixx="4.266957e-06" ixy="4.103313e-06" ixz="0.000000e+00" iyy="2.329528e-05" iyz="0.000000e+00" izz="2.249340e-05" />
    </inertial>
    <visual>
      <origin xyz="0.090726 0.097578 0.004000" rpy="3.141593 0.000000 1.531470" />
      <geometry>
        <mesh filename="package://garra_final_description/meshes/Configura_o_1/P_1.dae" scale="1 1 1" />
      </geometry>
      <material name="A_o" />
    </visual>
    <collision>
      <origin xyz="0.090726 0.097578 0.004000" rpy="3.141593 0.000000 1.531470" />
      <geometry>
        <mesh filename="package://garra_final_description/meshes/Configura_o_1/P_1.dae" scale="1 1 1" />
      </geometry>
    </collision>
  </link>
  <link name="P_1_1">
    <inertial>
      <origin xyz="-0.036361 -0.029895 0.002000" rpy="0 0 0" />
      <mass value="0.067383" />
      <inertia ixx="8.541989e-06" ixy="-8.939125e-06" ixz="0.000000e+00" iyy="1.902025e-05" iyz="0.000000e+00" izz="2.249340e-05" />
    </inertial>
    <visual>
      <origin xyz="0.076169 0.044258 0.004000" rpy="3.141593 0.000000 1.926866" />
      <geometry>
        <mesh filename="package://garra_final_description/meshes/Configura_o_1/P_1_1.dae" scale="1 1 1" />
      </geometry>
      <material name="A_o" />
    </visual>
    <collision>
      <origin xyz="0.076169 0.044258 0.004000" rpy="3.141593 0.000000 1.926866" />
      <geometry>
        <mesh filename="package://garra_final_description/meshes/Configura_o_1/P_1_1.dae" scale="1 1 1" />
      </geometry>
    </collision>
  </link>
  <joint name="R_gido" type="fixed">
    <parent link="base_link" />
    <child link="shoulder_motor" />
    <origin xyz="-0.002399 0.000644 0.000258" rpy="0.000000 0.011578 0.000000" />
  </joint>
  <joint name="Revolucionar_46" type="revolute">
    <parent link="shoulder_motor" />
    <child link="garra_final_showder_servo_horn" />
    <origin xyz="-0.023838 -0.025144 0.086064" rpy="1.570796 1.131260 0.000000" />
    <axis xyz="0.000000 0.000000 1.000000" />
    <limit lower="-0.63" upper="1.82" effort="1.86" velocity="1.30" />
  </joint>
  <joint name="R_gido_47" type="fixed">
    <parent link="garra_final_showder_servo_horn" />
    <child link="M_dulo_1" />
    <origin xyz="0.074914 0.050317 -0.030000" rpy="-1.570796 0.000000 1.832596" />
  </joint>
  <joint name="R_gido_48" type="fixed">
    <parent link="M_dulo_1" />
    <child link="MOTOR_1" />
    <origin xyz="0.002592 -0.000644 0.004103" rpy="0.000000 0.000000 0.000000" />
  </joint>
  <joint name="Revolucionar_49" type="revolute">
    <parent link="MOTOR_1" />
    <child link="garra_final_showder_servo_horn_2" />
    <origin xyz="0.059838 -0.008856 0.173222" rpy="1.570796 1.536874 0.000000" />
    <axis xyz="0.000000 0.000000 -1.000000" />
    <limit lower="-1.47" upper="1.35" effort="1.86" velocity="1.30" />
  </joint>
  <joint name="R_gido_50" type="fixed">
    <parent link="garra_final_showder_servo_horn_2" />
    <child link="M_dulo_2" />
    <origin xyz="0.160854 0.091479 -0.006666" rpy="-1.570796 0.000000 2.443461" />
  </joint>
  <joint name="R_gido_65" type="fixed">
    <parent link="M_dulo_2" />
    <child link="MOTOR_1_1" />
    <origin xyz="-0.000300 -0.000428 0.000662" rpy="0.000000 0.000000 0.000000" />
  </joint>
  <joint name="Revolucionar_72" type="revolute">
    <parent link="MOTOR_1_1" />
    <child link="garra_final_showder_servo_horn_3" />
    <origin xyz="0.146796 0.022261 0.173559" rpy="1.570796 1.545249 3.141593" />
    <axis xyz="0 0 -1" />
    <limit lower="-1.25" upper="1.3" effort="1.86" velocity="1.30" />
  </joint>
  <joint name="R_gido_73" type="fixed">
    <parent link="garra_final_showder_servo_horn_3" />
    <child link="Base" />
    <origin xyz="0.001272 -0.004945 0.062500" rpy="-0.896983 -1.570796 0.386126" />
  </joint>
  <joint name="R_gido_77" type="fixed">
    <parent link="Base" />
    <child link="Motor" />
    <origin xyz="-0.113471 -0.081721 -0.023500" rpy="0.000000 0.000000 0.000000" />
  </joint>
  <joint name="Revolucionar_85" type="fixed">
    <parent link="Base" />
    <child link="Engr_2" />
    <origin xyz="-0.069250 -0.055000 0.004000" rpy="-3.141593 0.000000 1.570796" />
  </joint>
  <joint name="Revolucionar_87" type="fixed">
    <parent link="Base" />
    <child link="Junta_1" />
    <origin xyz="-0.067140 -0.079000 0.004000" rpy="-3.141593 0.000000 1.570796" />
  </joint>
  <joint name="Revolucionar_89" type="fixed">
    <parent link="Base" />
    <child link="Junta_1_1" />
    <origin xyz="-0.067140 -0.079000 0.000000" rpy="-3.141593 0.000000 1.570796" />
  </joint>
  <joint name="Revolucionar_91" type="fixed">
    <parent link="Base" />
    <child link="Engr_1" />
    <origin xyz="-0.046750 -0.055000 0.004000" rpy="-3.141593 0.000000 1.570796" />
  </joint>
  <joint name="Revolucionar_93" type="fixed">
    <parent link="Base" />
    <child link="Junta_2" />
    <origin xyz="-0.048860 -0.079000 0.004000" rpy="-3.141593 0.000000 1.570796" />
  </joint>
  <joint name="Revolucionar_95" type="fixed">
    <parent link="Base" />
    <child link="Junta" />
    <origin xyz="-0.048860 -0.079000 0.000000" rpy="-3.141593 0.000000 1.570796" />
  </joint>
  <joint name="Revolucionar_86" type="fixed">
    <parent link="Engr_2" />
    <child link="P_1" />
    <origin xyz="-0.035079 -0.028187 0.000000" rpy="0.000000 0.000000 0.000000" />
  </joint>
  <joint name="Revolucionar_92" type="fixed">
    <parent link="Engr_1" />
    <child link="P_1_1" />
    <origin xyz="-0.000081 0.045000 0.000000" rpy="0.000000 0.000000 0.000000" />
  </joint>
  <!-- ROS 2 control: generated generic system -->
</robot>
