Arthur-Demetrio/garra/(commit log)

2026-11-02 feat: valida as informações da configuração
    [garra_final.urdf]
2026-11-06 docs:adiciona o readme
    [Nova_Pin_a.urdf.xacro, calibracao_servos.yaml, garra_final.ros2_control.xacro, garra_final.urdf, garra_final.urdf.xacro, ros2_controllers.yaml]
2026-11-09 docs: modifica o readme e adiciona um guia de testes
2026-11-09 docs: adiciona um planejamento para a garra
2026-11-09 docs: adiciona um referencial com as medidas do robô para acoplar a garra
2026-11-10 feat: integra novo URDF da garra e prepara o teste fisico
    [calibracao_servos.yaml, garra_final.ros2_control.xacro, garra_final.urdf, garra_final.urdf.xacro, joint_limits.yaml, ros2_controllers.yaml]
2026-11-10 fix(moveit): modela a placa da base com 1 cm de espessura
    Todas as placas (base, andar 1 e andar 2) tem 1 cm e as alturas
    medidas sao das superficies superiores. O chassi sob a placa da base
    fica como volume solido provisorio ate ser medido.
    [garra_final.urdf.xacro]
2026-11-10 feat: calibra os servos e ajusta os limites das juntas
    - calibracao_servos.yaml com zero, sentido e faixa medidos de J1-J3
    - limites das juntas no URDF (via ajustar_urdf.py) restritos a faixa calibrada
    - planejamento.md atualizado com a situacao atual e os proximos passos
    [calibracao_servos.yaml, garra_final.urdf]
2026-11-10 fix: usa /dev/ttyUSB0 como porta padrao do Arduino
    O Mega da garra usa conversor CH340 e aparece como /dev/ttyUSB0.
    [garra_final.urdf.xacro]
2026-11-10 feat: aumenta a velocidade da garra para ~1,27 rad/s
    Firmware passa a andar 15 us a cada 20 ms (~73 graus/s). joint_limits.yaml
    (max_velocity 1.26, max_acceleration 3.0) e o limite do URDF acompanham o
    firmware, ja que os servos nao informam a posicao. cliente_garra.py passa a
    usar os mesmos limites de junta do URDF.
    [garra_final.urdf, joint_limits.yaml]
2026-11-10 feat: integra o J4, mede a escala dos servos e muda a pose pronta
    - J4 (dedos): servo DS-S006MP no pino 12 no firmware (comando manual 4,<angulo>
    e J4 opcional no comando M); driver aceita 3 ou 4 juntas; junta provisoria
    "dedos" no xacro (os dedos da malha seguem fixos ate o mimic);
    garra_dedos_controller (GripperActionController) e grupo "dedos" no MoveIt,
    com os estados aberta (0) e fechada (95 graus, presa no cubo)
    - calibrar_servos.py preserva a entrada do J4 ao regravar a calibracao
    - scripts/medir_escala.py mede o us_por_rad real com um inclinometro:
    J1 -636.2, J2 -646.8, J3 -713.2 (antes -590.8 nominal), o que corrige a
    diferenca entre o RViz e a garra real longe do zero;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
    [calibracao_servos.yaml, garra_final.ros2_control.xacro, garra_final.urdf, garra_final.urdf.xacro, joint_limits.yaml, ros2_controllers.yaml]
2026-11-12 fix(moveit): usa so o OMPL como planejador
    O RViz ignora o pipeline padrao do move_group: escolhia o STOMP, que desloca o 1o ponto e aborta a execucao (start point deviates), ou o Pilz sem planner_id, que recusa o planejamento.
2026-11-12 feat: adiciona o script pegar_cubo.py para coletar um cubo sozinho
    Recebe a posicao do cubo em robo_base, escolhe a inclinacao da garra, entra em reta, fecha os dedos (85 graus), sobe e volta para a pronta. --descer (padrao 5 mm) compensa o modelo conservador perto do chao; --soltar devolve o cubo. cliente_garra.py: fk/ik aceitam outro frame.
2026-11-12 fix(moveit): fecha os dedos em 85 graus no estado fechada
    Em 95 graus os dedos forcavam o cubo e travavam as engrenagens; 85 graus segura o cubo de 42 mm.
    [garra_final.urdf.xacro]
2026-11-12 feat: aumenta a descida extra padrao do pegar_cubo.py para 10 mm
2026-11-13 docs: adiciona ao guia de testes como pegar o cubo com o pegar_cubo.py
2026-11-13 feat: adiciona deteccao de cubos por AprilTag com a webcam
    camera_cubo.py detecta os cubos pelo AprilTag 36h11 com a webcam fixa,
    converte o centro do cubo para robo_base e publica em /pegar_cubo
    (tecla P ou --auto). Usa a calibracao da webcam e a pose da camera do
    repositorio niviton/-WORK e funciona com o OpenCV 4.6 do ROS Jazzy.
    Le a etiqueta branca inteira quando o tag do topo e visto muito de lado,
    caso em que o detector do OpenCV rejeita o candidato.
    calibrar_camera.py mede ao vivo a inclinacao e a altura da camera pelos
    tags e salva em camera_montagem.json.
    [camera_calib_webcam.yaml, robot_config_webcam.yaml]
2026-11-13 feat: adiciona sensor de cubo nos dedos (chave fim de curso)
    Firmware responde ao comando S; o driver pergunta a 20 Hz e publica em
    /garra/cubo_preso. testar_sensor.py testa a chave direto pela serial.
2026-11-13 feat: pegar_cubo.py escuta /pegar_cubo e confere o sensor dos dedos
2026-11-13 fix: recalibra o J1 apos reposicionar o servo no eixo
    zero_us 1678, faixa 504-2091 us; limite do J1 passa a -0.63..1.82 rad.
    [calibracao_servos.yaml, garra_final.urdf]
2026-11-13 feat: adiciona a plataforma do eixo Y (68,39 mm) com colisao temporaria
    Bloco de 12x12 cm sob a garra ate as medidas reais. Testes de colisao do
    validar_garra.py ajustados a garra elevada.
    [garra_final.urdf.xacro]
2026-11-13 docs: adiciona foto do novo zero do servo do J1
